jennaniwens/fiveprime2019-overflow_sensor/CAD/drafts/support.PNG

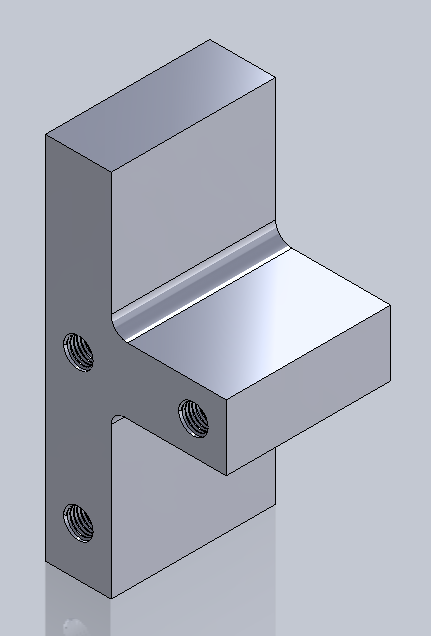
CAD/drafts/support.PNG
