jennaniwens/fiveprime2019-overflow_sensor/CAD/drafts/tomachine.PNG

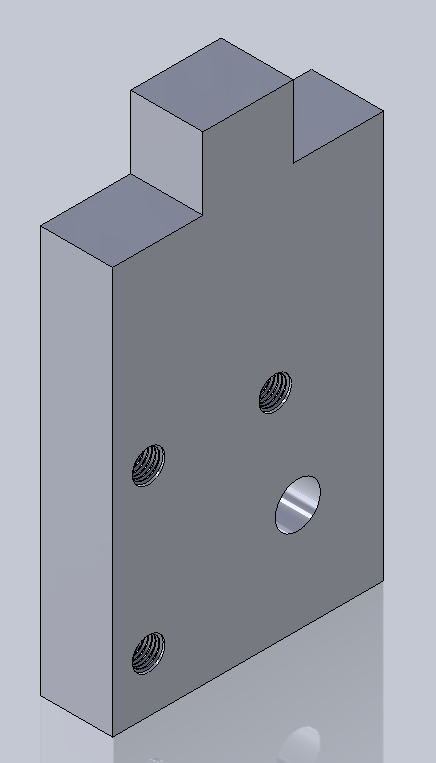
CAD/drafts/tomachine.PNG
