jennaniwens/fiveprime2019-overflow_sensor/CAD/drafts/tosensor.PNG

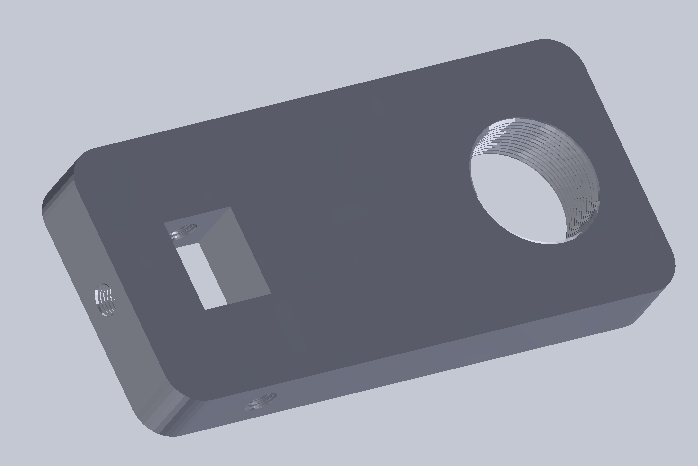
CAD/drafts/tosensor.PNG
