jennaniwens/fiveprime2019-overflow_sensor/CAD/final/Holder.PNG

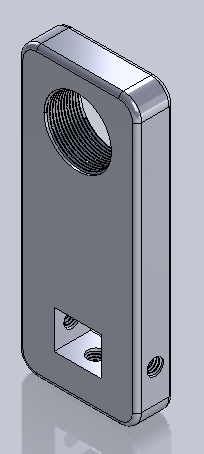
CAD/final/Holder.PNG
