jennaniwens/fiveprime2019-overflow_sensor/CAD/final/MountSupport.PNG

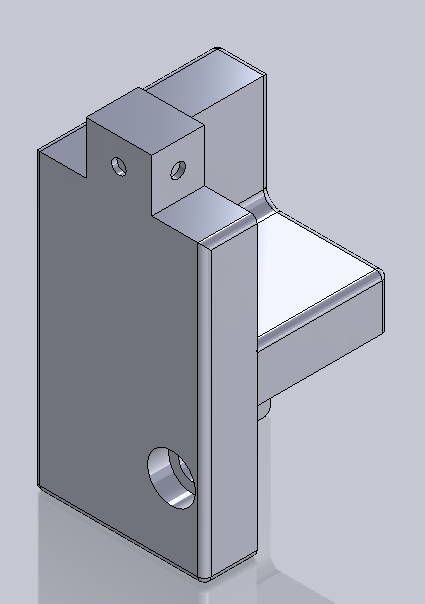
CAD/final/MountSupport.PNG
