jennaniwens/fiveprime2019-overflow_sensor/BOM.xlsx

Vendor | Part # | Description | Price | Quantity | Link
McMaster; Fibox | 7360K642 | enclosure | 32.25 | 1 | https://www.mcmaster.com/7360k642
McMaster | 69945K22 | panels for enclosure | 4.6 | 2 | https://www.mcmaster.com/69945k22
McMaster | 7529K132 | cord grip | 9.5 | 3 | https://www.mcmaster.com/7529k132
McMaster | 7466K35 | locknut and o-ring for cord group | 1.65 | 2 | https://www.mcmaster.com/7466K35
McMaster; Omron | 7675K85 | PNP NO object proximity sensor (16.6 v 18mm dia) | 149.66 | 1 | https://www.mcmaster.com/7675k85
McMaster | 7641K921 | modular rail mount terminal block | 1.16 | 4 | https://www.mcmaster.com/7641k921
McMaster | 7641K33 | end cover for modular rail block | 0.37 | 1 | https://www.mcmaster.com/7641K33
McMaster | 7641K35 | end stop for modular rail block (not exactly) | 0.72 | 1 | https://www.mcmaster.com/7641K35
Digikey; Omron | 7009K33 | 12V 1A AD-DC power supply | 70.55 | 1 | https://www.mcmaster.com/7009k33
Phidgets | 3051_1 | 12V dual NO+NC DC Relay | 19 | 1 | https://www.phidgets.com/?tier=3&catid=46&pcid=39&prodid=191
Grainger | 39121514 | DC-AC solid state NC relay w/ heat sink | 46.09 | 1 | https://www.grainger.com/product/CRYDOM-1-Pole-Surface-Mount-Solid-1DTJ7
McMaster | 7343K29 | toggle NC switch | 10.3 | 1 | https://www.mcmaster.com/7343k29
Digikey; Omron | Z5549-ND | indicator light for status of circuit | 12.58 | 1 | https://www.digikey.com/product-detail/en/omron-automation-and-safety/M22N-BC-TRA-RB/Z5549-ND/5604055
Digikey | 10A02-TDICT-ND | diode | 0.72 | 2 | https://www.digikey.com/product-detail/en/diodes-incorporated/10A02-T/10A02-TDICT-ND/2242770
Digikey; Littelfuse | F4036-ND | varistor | 2.13 | 1 | https://www.digikey.com/product-detail/en/littelfuse-inc/TMOV20RP200E/F4036-ND/1210654
McMaster | 90291A192 | plastic-tipped set screws | 8.49 | 1 | https://www.mcmaster.com/90291a192
McMaster | 92949A544 | bolt for attaching sensor mount to washer | 5.48 | 1 | https://www.mcmaster.com/92949a544
McMaster | 9470K25 | gasket material | 3.08 | 1 | https://www.mcmaster.com/9470k25
 |  |  | 407.78
