jennaniwens/fiveprime2019-overflow_sensor/CAD/final/ToMachineWithSupport.SLDASM

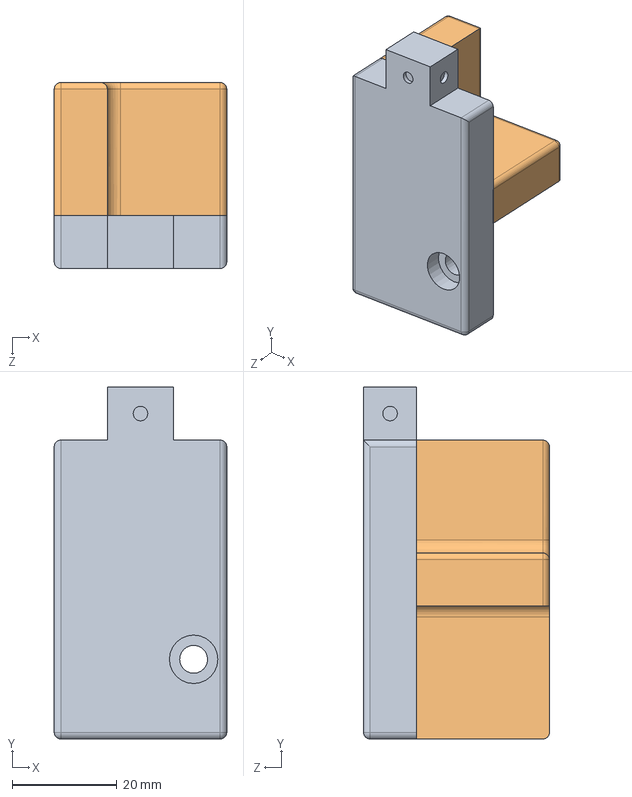
[picture p15: CAD file, 2020-01-28]
CAD/final/ToMachineWithSupport.SLDASM
33.0 x 67.3 x 35.6 mm
ToMachine5NoHole
Support6NoHole
