jennaniwens/fiveprime2019-overflow_sensor/CAD/drafts/SensorMountSupport.SLDPRT

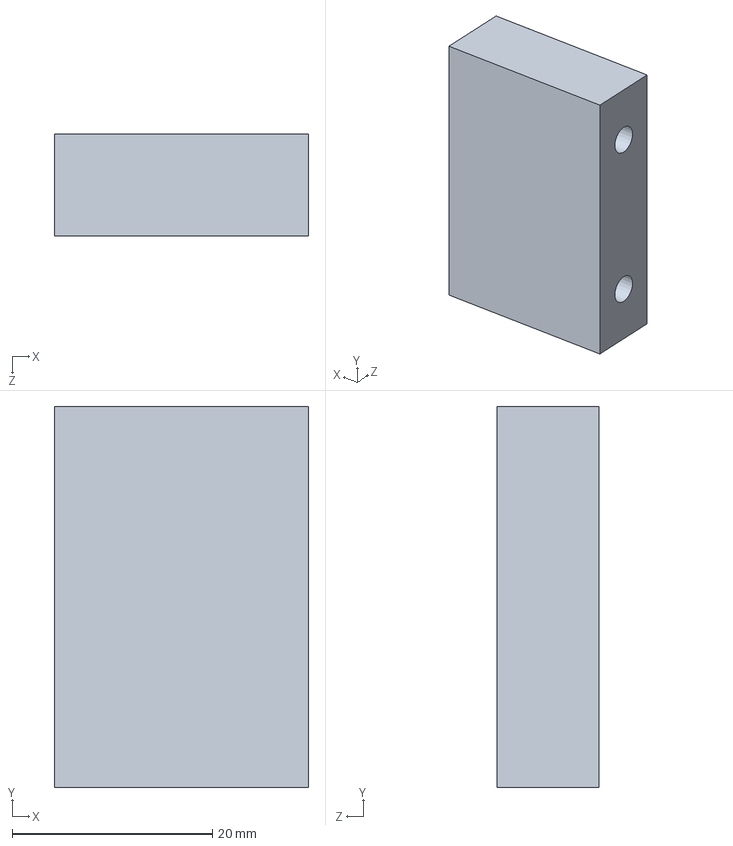
[picture p16: CAD file, 2020-01-28]
CAD/drafts/SensorMountSupport.SLDPRT
25.4 x 38.1 x 10.2 mm
