jennaniwens/fiveprime2019-overflow_sensor/CAD/drafts/ToMachine2.SLDPRT

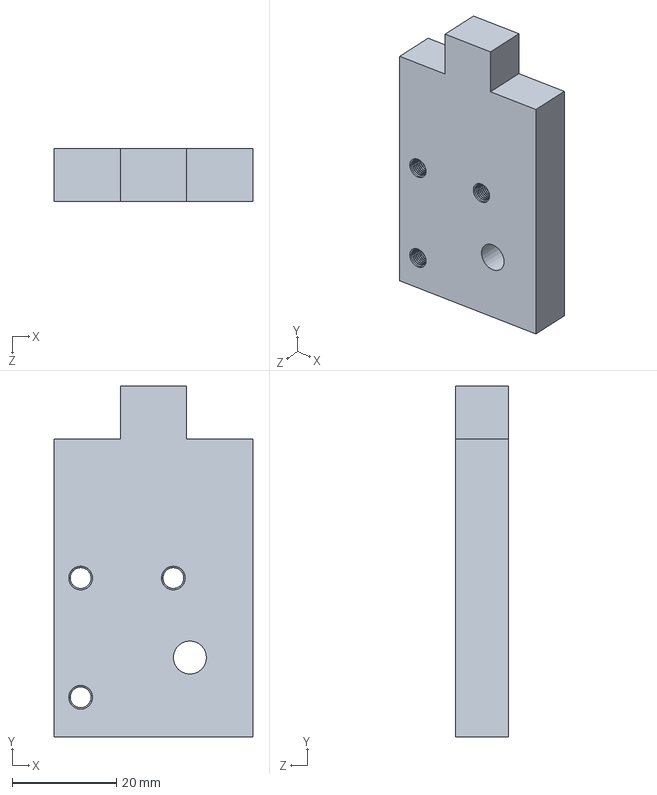
[picture p17: CAD file, 2020-01-28]
CAD/drafts/ToMachine2.SLDPRT
38.1 x 67.3 x 10.2 mm
