jennaniwens/fiveprime2019-overflow_sensor/CAD/final/ToMachine5NoHole.SLDPRT

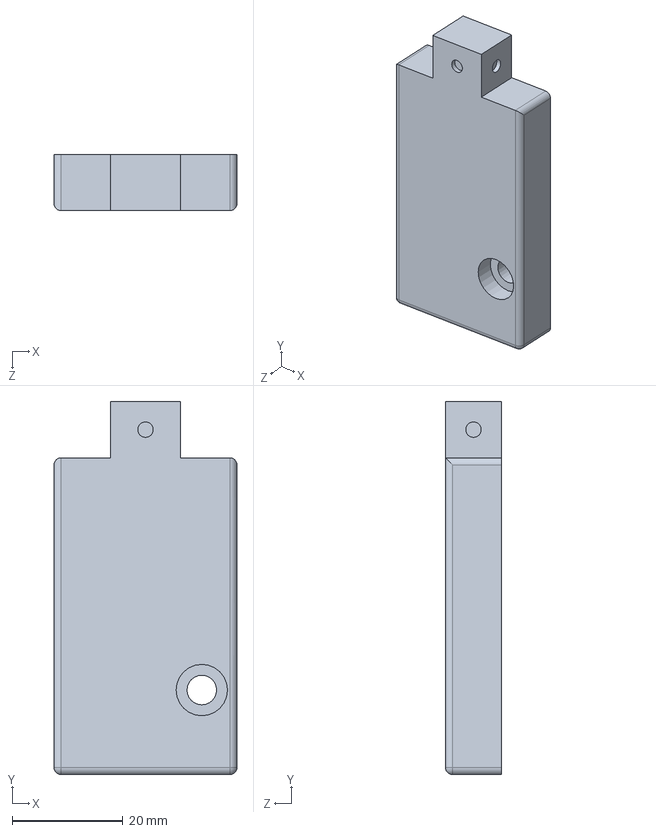
[picture p18: CAD file, 2020-01-28]
CAD/final/ToMachine5NoHole.SLDPRT
33.0 x 67.3 x 10.2 mm
