jennaniwens/fiveprime2019-overflow_sensor/CAD/final/ToSensor4.SLDPRT

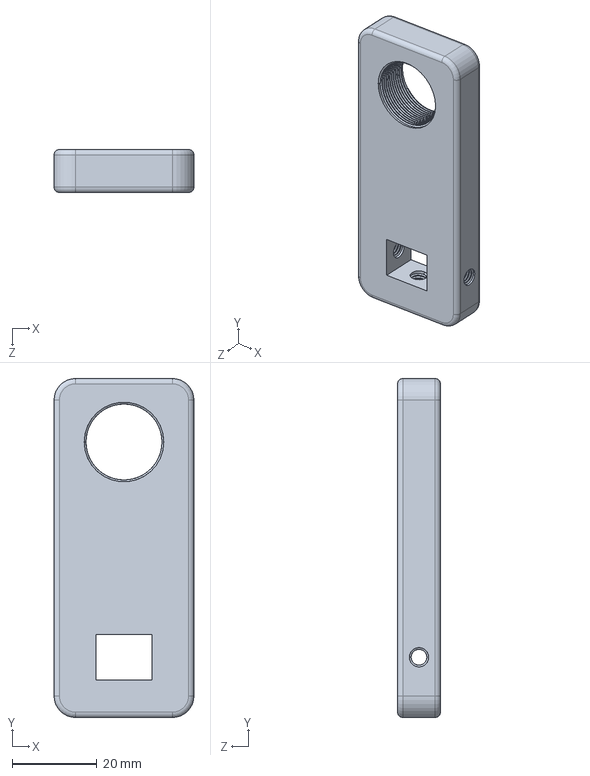
[picture p19: CAD file, 2020-01-28]
CAD/final/ToSensor4.SLDPRT
33.0 x 80.0 x 10.2 mm
