jennaniwens/fiveprime2019-overflow_sensor/CAD/drafts/threading.SLDPRT

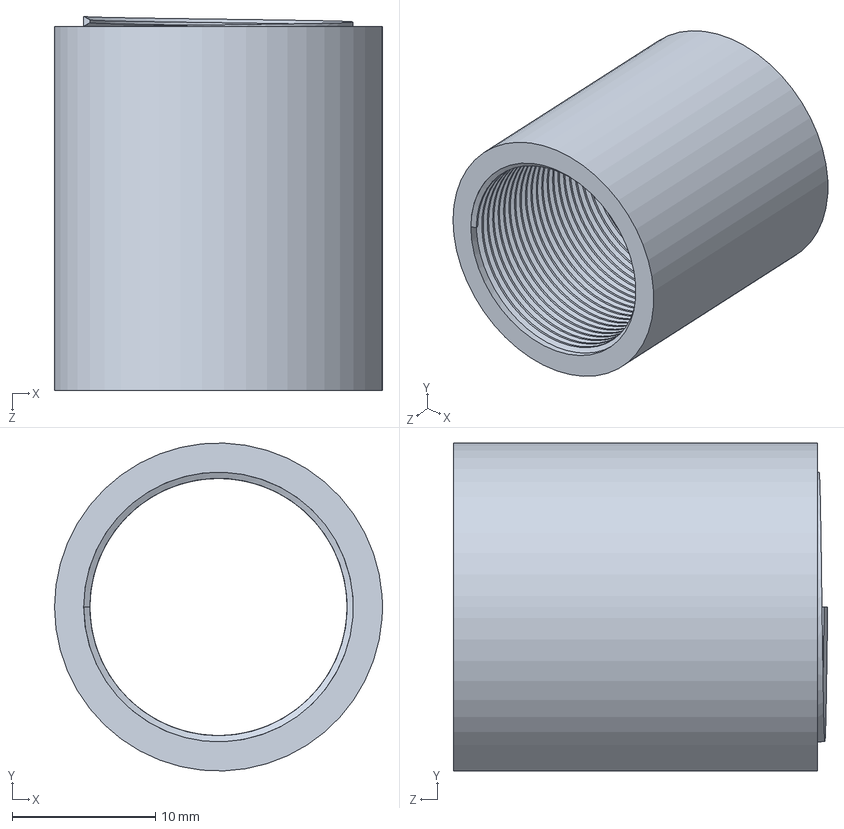
[picture p20: CAD file, 2020-01-28]
CAD/drafts/threading.SLDPRT
22.9 x 22.8 x 26.1 mm
