jennaniwens/fiveprime2019-overflow_sensor/CAD/final/Support6NoHole.SLDPRT

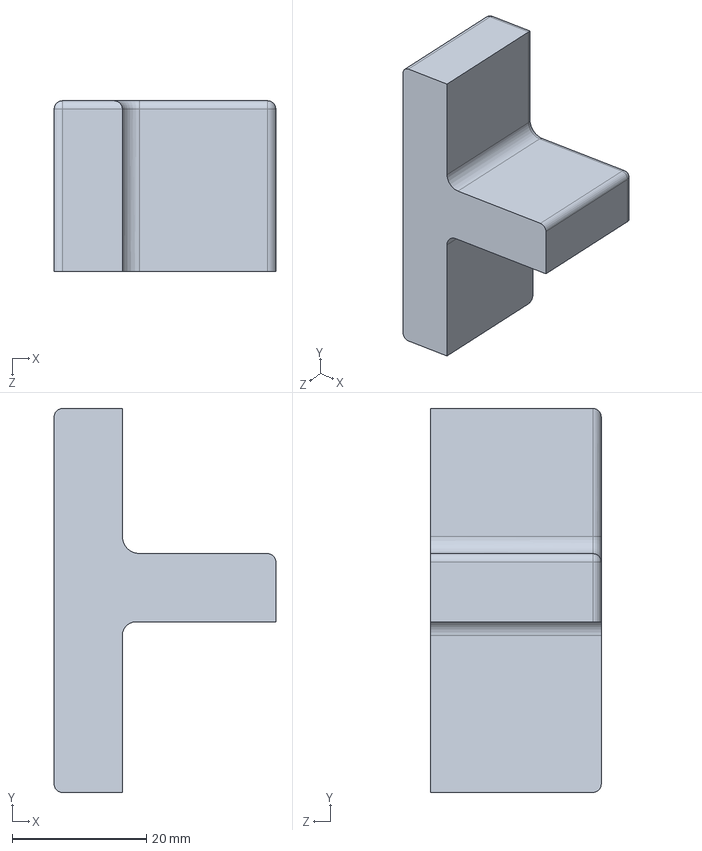
[picture p21: CAD file, 2020-01-28]
CAD/final/Support6NoHole.SLDPRT
33.0 x 57.1 x 25.4 mm
