jennaniwens/fiveprime2019-overflow_sensor/CAD/drafts/SensorMountToSensor.SLDPRT

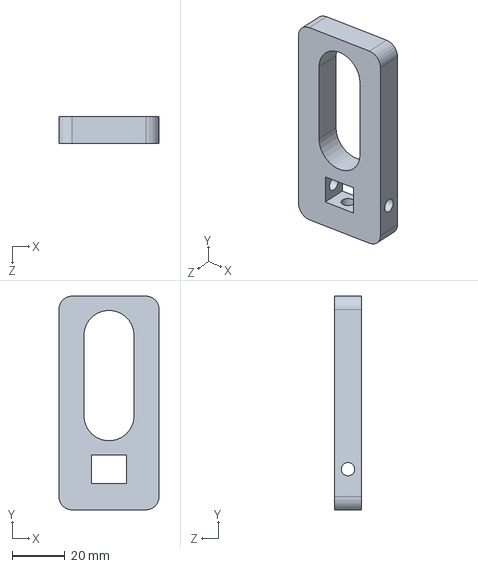
[picture p22: CAD file, 2020-01-28]
CAD/drafts/SensorMountToSensor.SLDPRT
38.1 x 81.3 x 10.2 mm
