jennaniwens/fiveprime2019-overflow_sensor/CAD/drafts/ToSensor2.SLDPRT

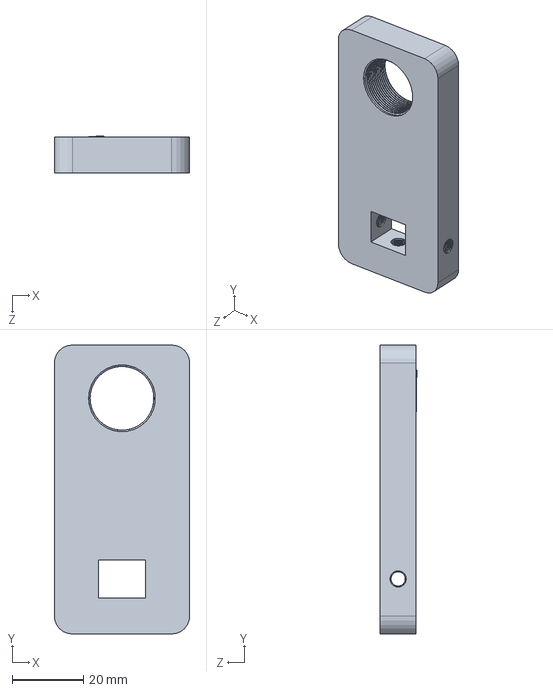
[picture p23: CAD file, 2020-01-28]
CAD/drafts/ToSensor2.SLDPRT
38.1 x 81.3 x 10.3 mm
