jennaniwens/fiveprime2019-overflow_sensor/CAD/drafts/ToMachine5.SLDPRT

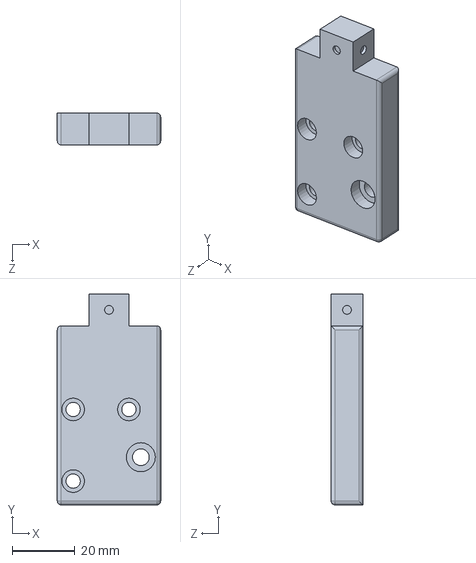
[picture p24: CAD file, 2020-01-28]
CAD/drafts/ToMachine5.SLDPRT
33.0 x 67.3 x 10.2 mm
