jennaniwens/fiveprime2019-overflow_sensor/CAD/drafts/DCRelayMount2.SLDPRT

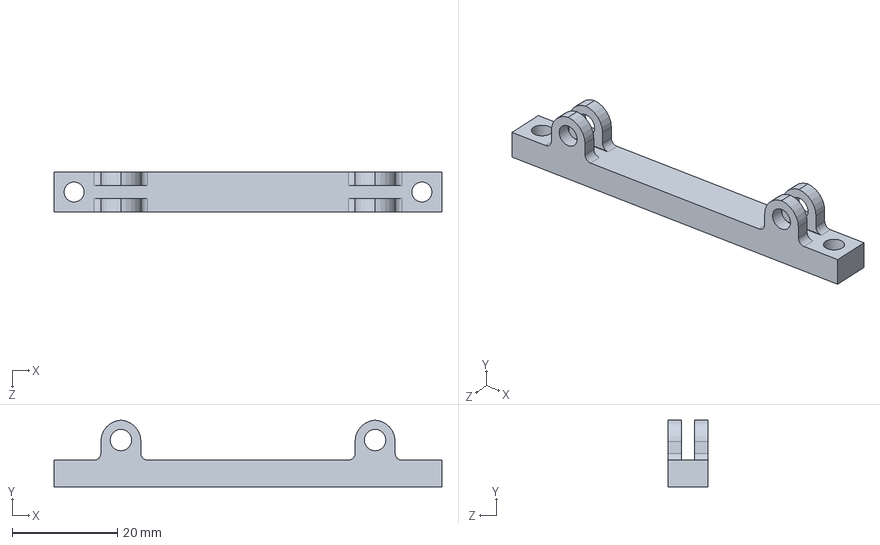
[picture p25: CAD file, 2020-01-28]
CAD/drafts/DCRelayMount2.SLDPRT
73.7 x 12.7 x 7.62 mm
