jennaniwens/fiveprime2019-overflow_sensor/CAD/drafts/SensorMount2_1.SLDPRT

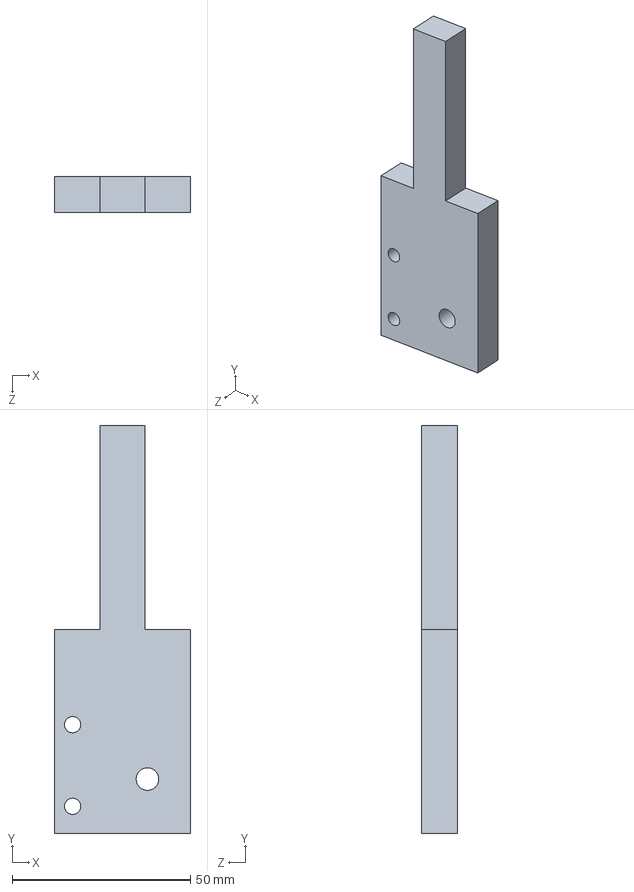
[picture p26: CAD file, 2020-01-28]
CAD/drafts/SensorMount2_1.SLDPRT
38.1 x 114.3 x 10.2 mm
