jennaniwens/fiveprime2019-overflow_sensor/CAD/drafts/threading2.SLDPRT

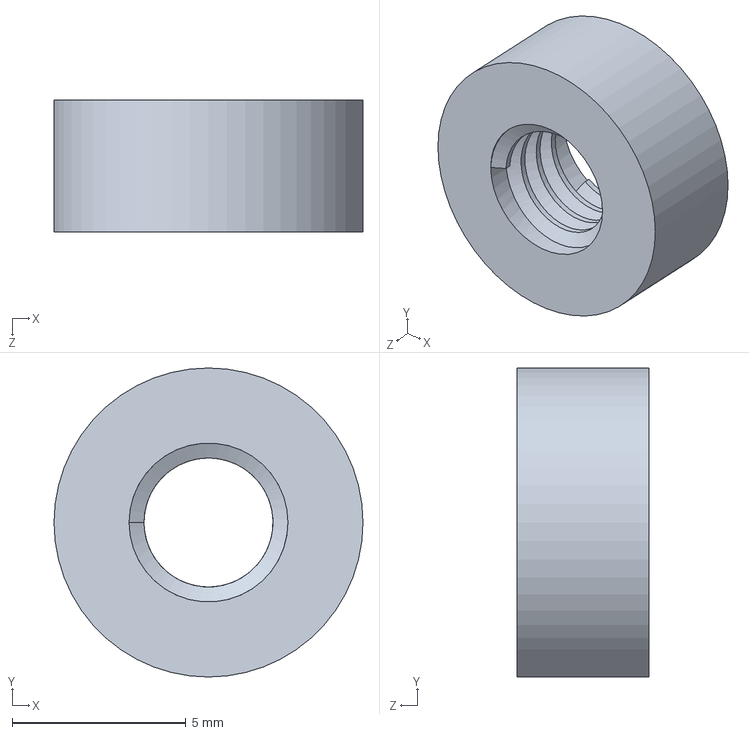
[picture p27: CAD file, 2020-01-28]
CAD/drafts/threading2.SLDPRT
8.89 x 8.89 x 3.81 mm
