jennaniwens/fiveprime2019-overflow_sensor/CAD/drafts/SensorMount.STL

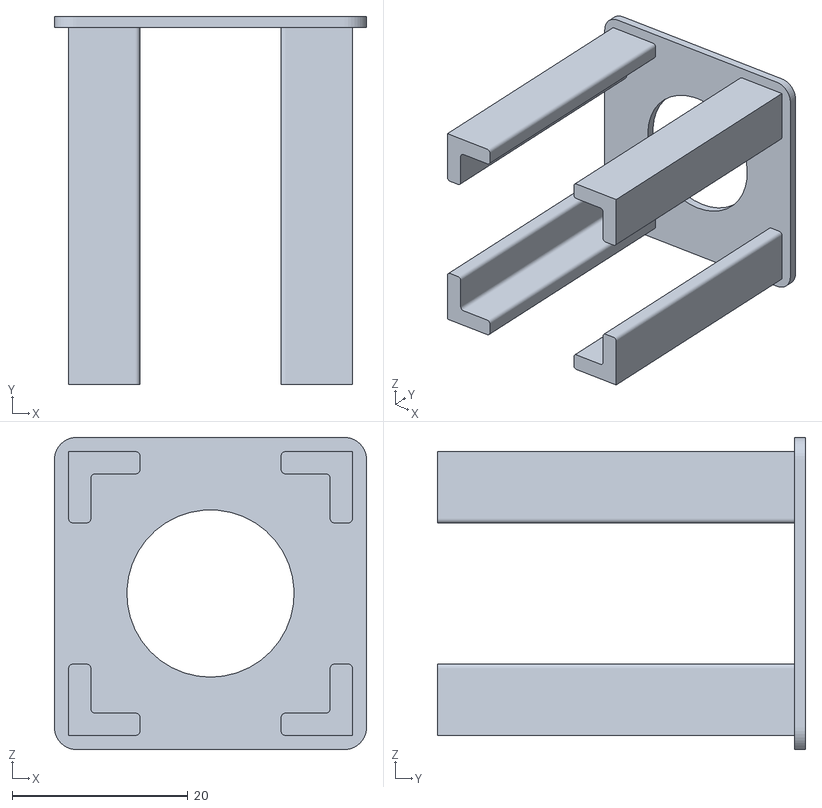
[picture p28: CAD file, 2020-01-28]
CAD/drafts/SensorMount.STL
35.6 x 41.9 x 35.6
