jennaniwens/fiveprime2019-overflow_sensor/CAD/drafts/threading1.STL

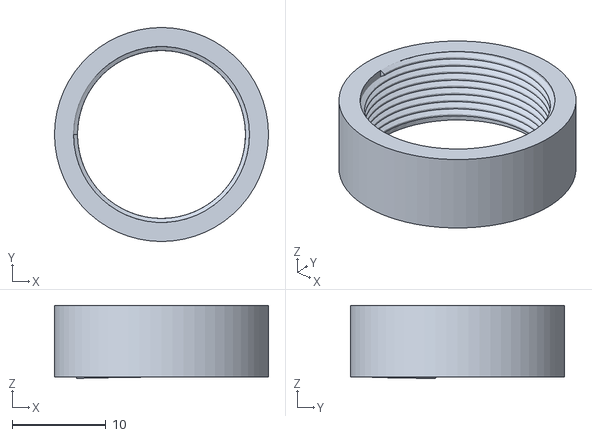
[picture p29: CAD file, 2020-01-28]
CAD/drafts/threading1.STL
22.9 x 22.9 x 7.81
