jennaniwens/fiveprime2019-overflow_sensor/CAD/drafts/Support4.SLDPRT

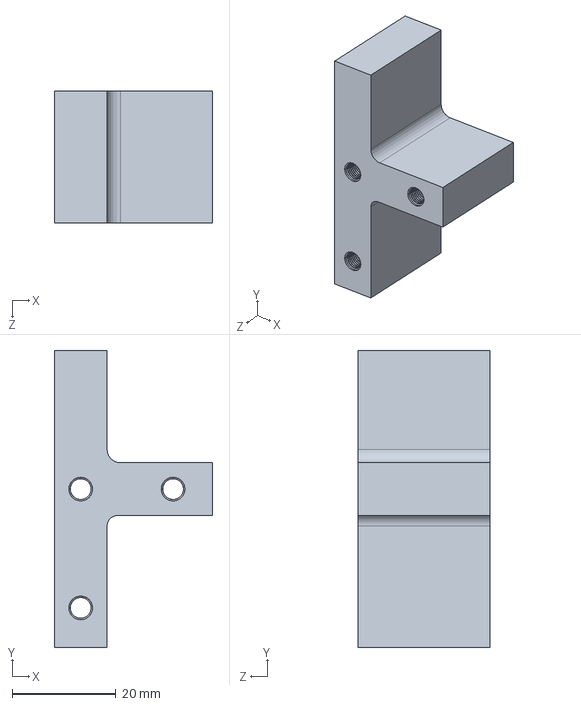
[picture p30: CAD file, 2020-01-28]
CAD/drafts/Support4.SLDPRT
30.5 x 57.1 x 25.4 mm
