jennaniwens/fiveprime2019-overflow_sensor/CAD/drafts/SensorMount2_2.SLDPRT

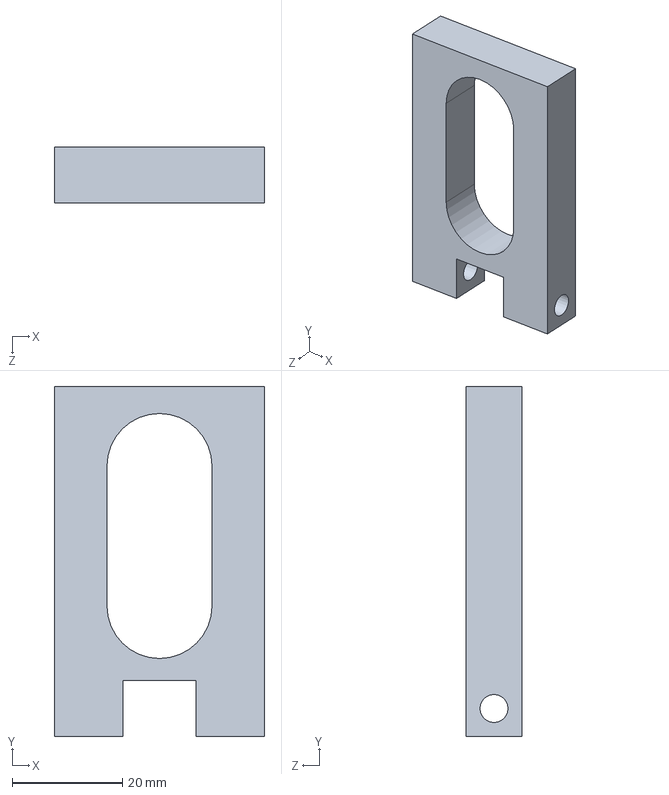
[picture p31: CAD file, 2020-01-28]
CAD/drafts/SensorMount2_2.SLDPRT
38.1 x 63.5 x 10.2 mm
