jennaniwens/fiveprime2019-overflow_sensor/CAD/drafts/SensorMountSupport2.SLDPRT

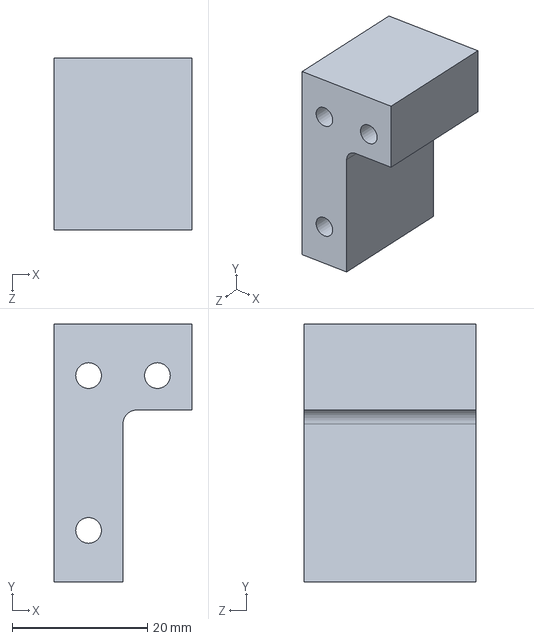
[picture p32: CAD file, 2020-01-28]
CAD/drafts/SensorMountSupport2.SLDPRT
20.3 x 38.1 x 25.4 mm
