jennaniwens/fiveprime2019-overflow_sensor/CAD/drafts/SensorMountSupport3.SLDPRT

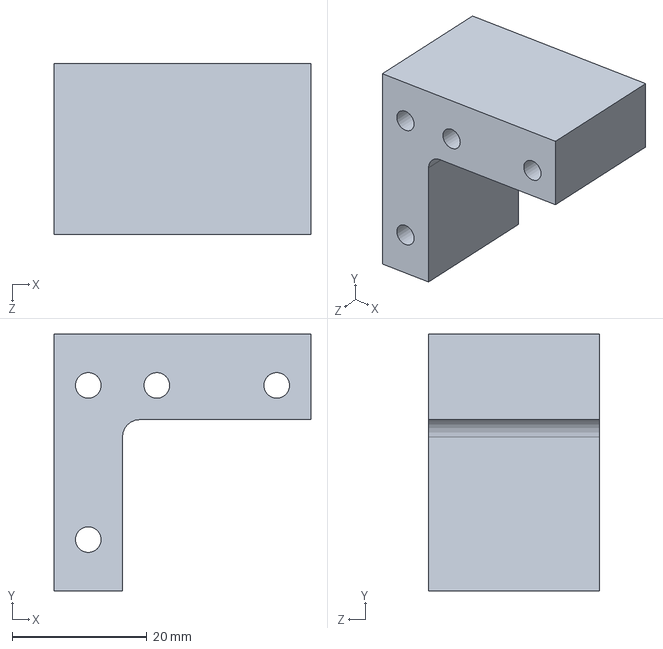
[picture p33: CAD file, 2020-01-28]
CAD/drafts/SensorMountSupport3.SLDPRT
38.1 x 38.1 x 25.4 mm
