jennaniwens/fiveprime2019-overflow_sensor/CAD/drafts/circle.STL

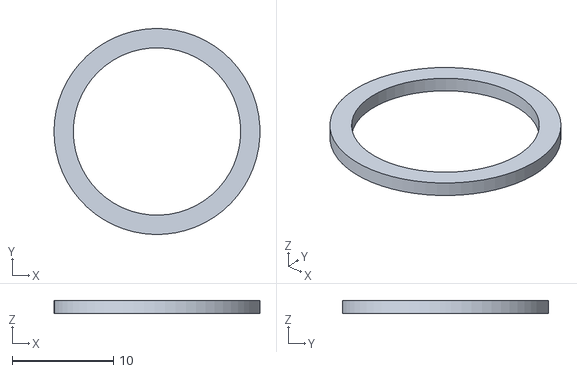
[picture p34: CAD file, 2020-01-28]
CAD/drafts/circle.STL
20.3 x 20.3 x 1.27
