jennaniwens/fiveprime2019-overflow_sensor/CAD/drafts/DCRelayMount.SLDPRT

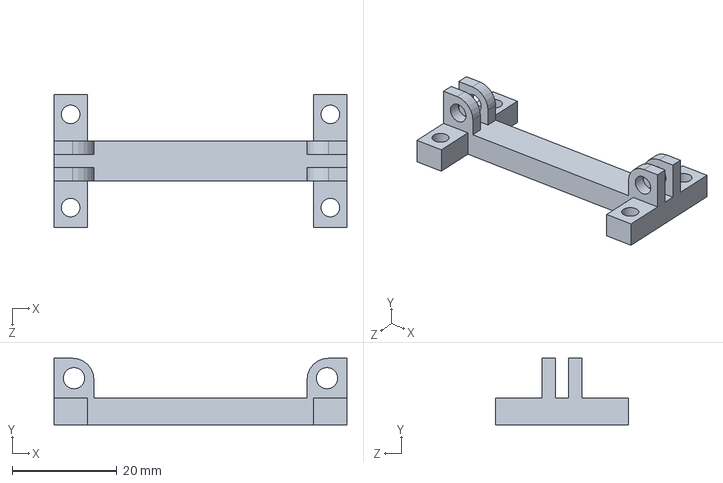
[picture p35: CAD file, 2020-01-28]
CAD/drafts/DCRelayMount.SLDPRT
55.9 x 12.7 x 25.4 mm
