jennaniwens/fiveprime2019-overflow_sensor/CAD/drafts/ToSensor3.SLDPRT

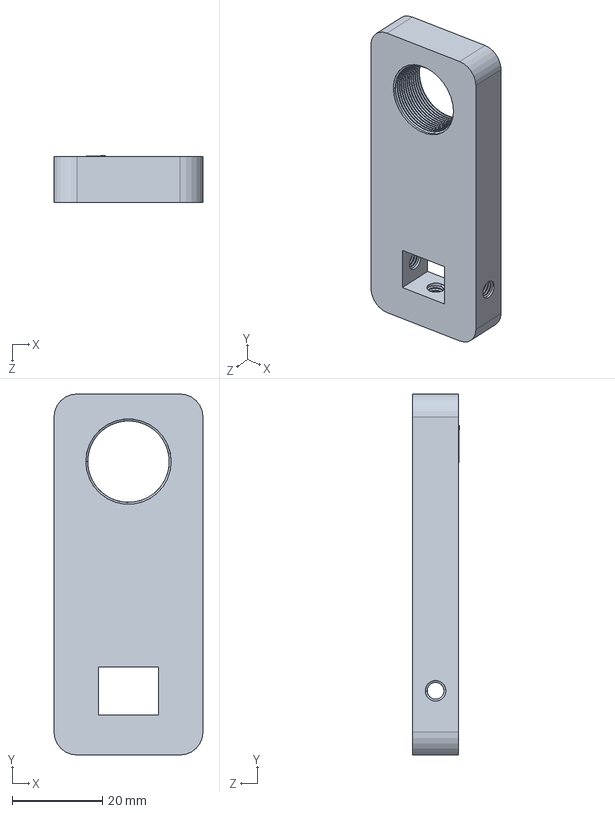
[picture p36: CAD file, 2020-01-28]
CAD/drafts/ToSensor3.SLDPRT
33.0 x 80.0 x 10.3 mm
