jennaniwens/fiveprime2019-overflow_sensor/CAD/drafts/SensorMountToMachine.SLDPRT

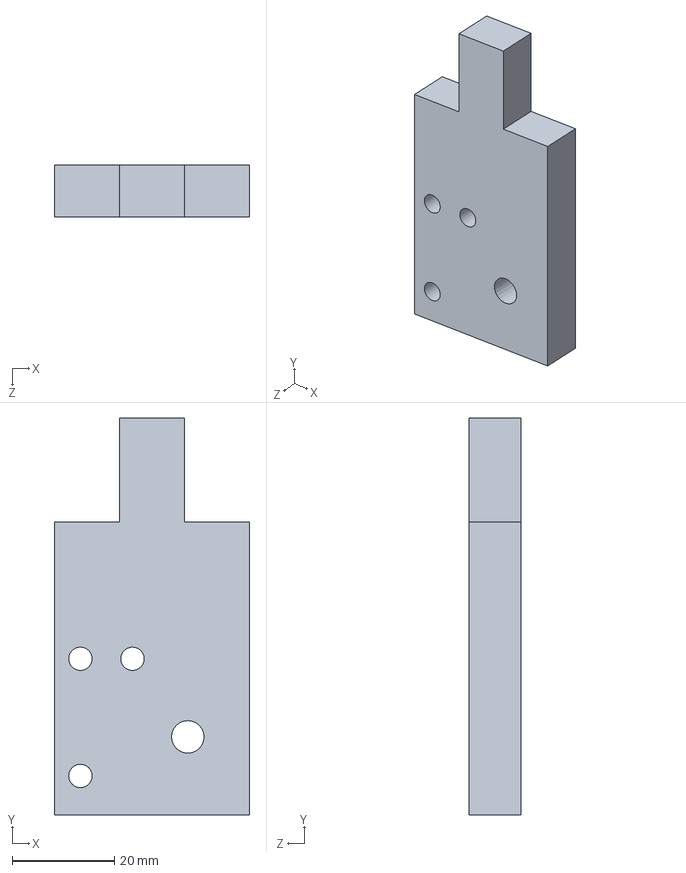
[picture p38: CAD file, 2020-01-28]
CAD/drafts/SensorMountToMachine.SLDPRT
38.1 x 77.5 x 10.2 mm
