jennaniwens/fiveprime2019-overflow_sensor/(list of files, cad)

Other CAD files:
CAD/drafts/ToMachine3.SLDPRT
CAD/drafts/ToMachine4.SLDPRT
CAD/drafts/SensorMount2.SLDPRT
CAD/drafts/MountSupport.SLDPRT
CAD/drafts/ToSensor4.SLDPRT
CAD/drafts/DCRelayMount2.STL
CAD/drafts/SensorMount2.STL
CAD/drafts/SensorMount2_1.STL
CAD/drafts/SensorMount2_2.STL
CAD/drafts/SensorMountSupport2.STL
CAD/drafts/SensorMountToMachine.STL
CAD/drafts/SensorMountToSensor.STL
CAD/drafts/Support4.STL
CAD/drafts/ToMachine2.STL
CAD/drafts/ToMachine3.STL
CAD/drafts/ToMachine4.STL
CAD/drafts/ToMachine5.STL
CAD/drafts/ToSensor2.STL
CAD/drafts/ToSensor3.STL
CAD/drafts/ToSensor4.STL
CAD/drafts/threading.STL
CAD/drafts/threading2.STL
CAD/final/Support6NoHole.STL
CAD/final/ToMachine5NoHole.STL
CAD/final/ToSensor4.STL
